bobbycar-graz/bobby-flasher/README.md

# bobby-flasher

### Screenshots
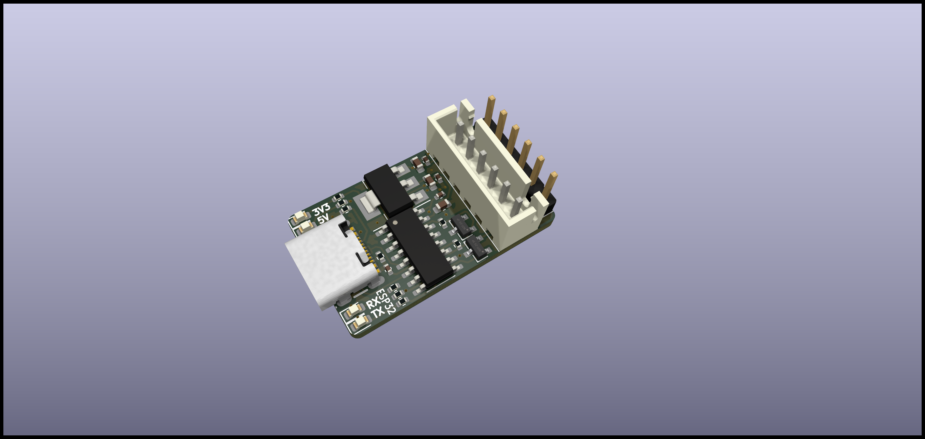
[picture p1: bobby-flasher.png]
Image of pcb
