bobbycar-graz/bobby-flasher/bobby-flasher.kicad_pcb

## KiCad design bobby-flasher.kicad_pcb (2026-01-31)

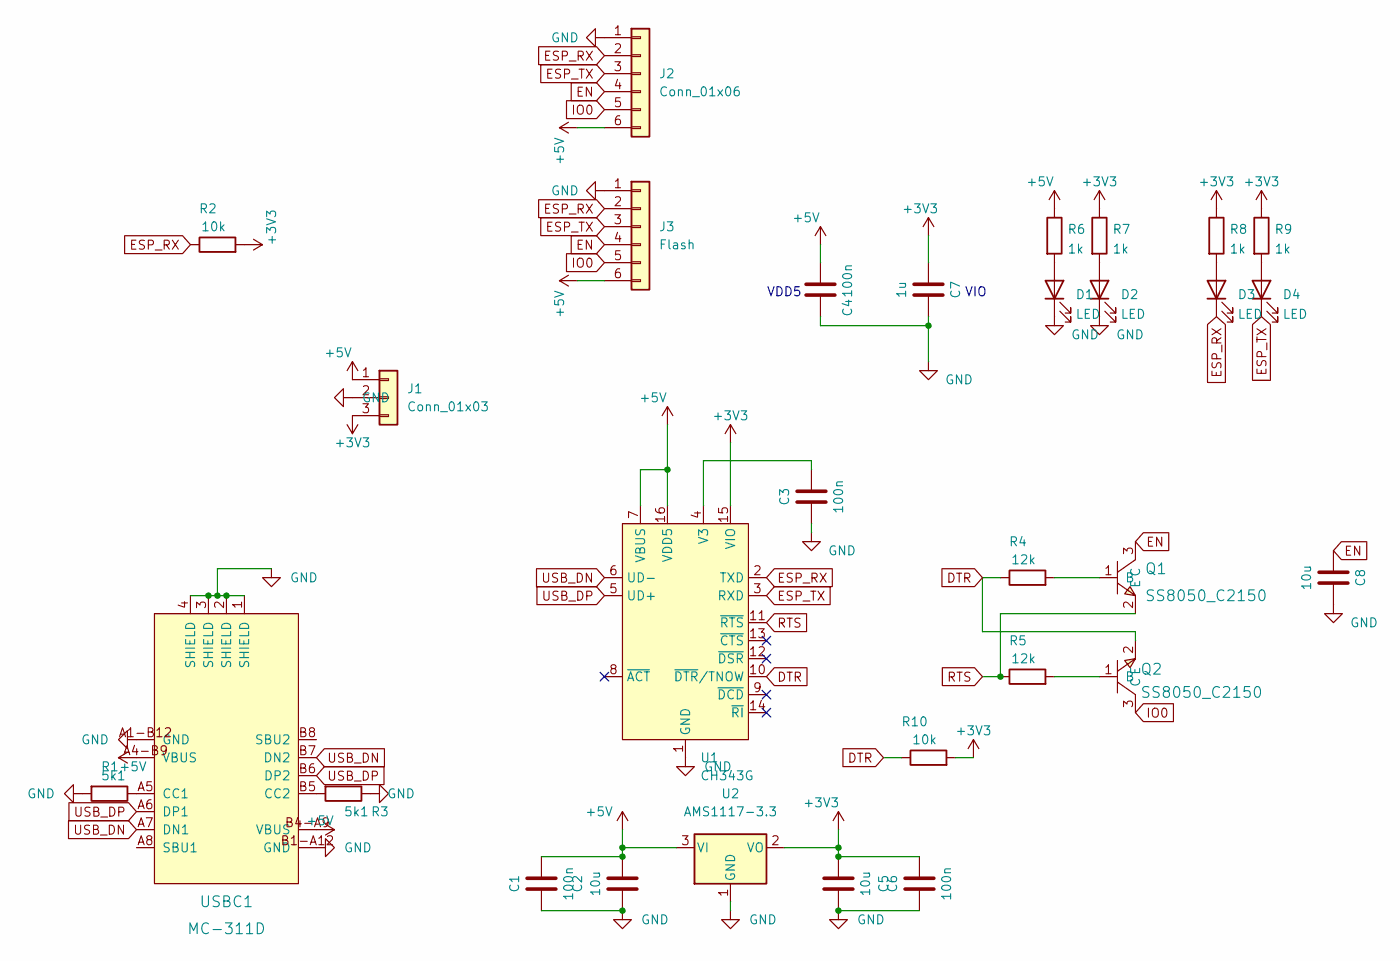
[picture p2: schematic bobby-flasher.kicad_sch]

Parts:
C1, C3, C4, C6: 100n; C_0402_1005Metric; LCSC Part # C1525
C2, C5, C8: 10u; C_0603_1608Metric; LCSC Part # C96446
C7: 1u; C_0603_1608Metric; LCSC Part # C15849
D1: LED; LED_0603_1608Metric; LCSC C2286
D2, D4: LED; LED_0603_1608Metric; LCSC C965807
D3: LED; LED_0603_1608Metric; LCSC C2290
J1: Conn_01x03; PinHeader_1x03_P2.54mm_Vertical
J2: Conn_01x06; PinHeader_1x06_P2.54mm_Vertical
J3: Flash; JST_XH_B6B-XH-A_1x06_P2.50mm_Vertical; LCSC C5663
Q1, Q2: SS8050_C2150; SOT-23; LCSC Part C2150
R1, R3: 5k1; R_0402_1005Metric; LCSC C25905
R2, R10: 10k; R_0402_1005Metric; LCSC C25744
R4, R5: 12k; R_0402_1005Metric; LCSC C25752
R6, R7, R8, R9: 1k; R_0402_1005Metric; LCSC C11702
U1: CH343G; SOIC-16_3.9x9.9mm_P1.27mm; LCSC C2844153
U2: AMS1117-3.3; SOT-223-3_TabPin2; LCSC C6186
USBC1: MC-311D; USB-C-SMD_MC-311D; LCSC Part C136423

Connections:
+3V3: C5.1, C6.2, C7.2, J1.3, R2.2, R7.1, R8.1, R9.1, R10.2, U1.15 (VIO), U2.2 (VO)
+5V: C1.2, C2.2, C4.2, J1.1, J2.6, J3.6, R6.1, U1.7 (VBUS), U1.16 (VDD5), U2.3 (VI), USBC1.A4-B9 (VBUS), USBC1.B4-A9 (VBUS)
DTR: Q2.2 (E), R4.1, R10.1, U1.10 (~DTR/TNOW)
EN: C8.2, J2.4, J3.4, Q1.3 (C)
ESP_RX: D3.1 (K), J2.2, J3.2, R2.1, U1.2 (TXD)
ESP_TX: D4.1 (K), J2.3, J3.3, U1.3 (RXD)
GND: C1.1, C2.1, C3.1, C4.1, C5.2, C6.1, C7.1, C8.1, D1.1 (K), D2.1 (K), J1.2, J2.1, J3.1, R1.2, R3.1, U1.1 (GND), U2.1 (GND), USBC1.1 (SHIELD), USBC1.2 (SHIELD), USBC1.3 (SHIELD), USBC1.4 (SHIELD), USBC1.A1-B12 (GND), USBC1.B1-A12 (GND)
IO0: J2.5, J3.5, Q2.3 (C)
unnamed: D1.2 (A), R6.2
unnamed: D2.2 (A), R7.2
unnamed: D3.2 (A), R8.2
unnamed: D4.2 (A), R9.2
unnamed: Q1.1 (B), R4.2
unnamed: Q2.1 (B), R5.2
unnamed: C3.2, U1.4 (V3)
unnamed: R1.1, USBC1.A5 (CC1)
unnamed: R3.2, USBC1.B5 (CC2)
RTS: Q1.2 (E), R5.1, U1.11 (~RTS)
USB_DN: U1.6 (UD-), USBC1.A7 (DN1), USBC1.B7 (DN2)
USB_DP: U1.5 (UD+), USBC1.A6 (DP1), USBC1.B6 (DP2)

Notes on the sheet:
VIO
VDD5

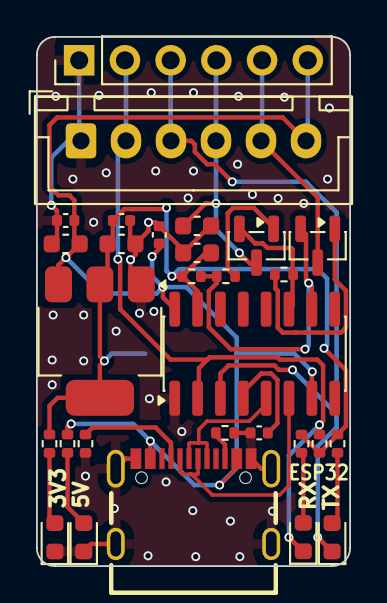
[picture p3: board bobby-flasher.kicad_pcb from above]

Board: 2 copper layers, 17.4 x 29.4 mm, 30 parts (1 on the bottom side), 20 nets.
