bobbycar-graz/bobby-flasher/(commit log)

2022-07-13 new layout, added leds
    [bobby-flasher.kicad_pcb, bobby-flasher.kicad_sch]
2022-07-13 Updated pcb
    [bobby-flasher.kicad_pcb]
2022-08-01 Updated files
    [bobby-flasher.kicad_pcb, bobby-flasher.kicad_sch]
2022-12-13 Added 10k pullup to DTR
    [bobby-flasher.kicad_pcb, bobby-flasher.kicad_sch]
2022-12-13 Updated schematic
    [bobby-flasher.kicad_sch]
2022-12-15 peters fixes, resistor on DTR missing
    [bobby-flasher-B_Cu.gbr, bobby-flasher-B_Mask.gbr, bobby-flasher-B_Paste.gbr, bobby-flasher-B_Silkscreen.gbr, bobby-flasher-CuBottom.gbr, bobby-flasher-CuTop.gbr, bobby-flasher-EdgeCuts.gbr, bobby-flasher-Edge_Cuts.gbr]
2024-12-11 fixed version
    [bobby-flasher-B_Cu.gbr, bobby-flasher-B_Mask.gbr, bobby-flasher-B_Paste.gbr, bobby-flasher-B_Silkscreen.gbr, bobby-flasher-CuBottom.gbr, bobby-flasher-CuTop.gbr, bobby-flasher-EdgeCuts.gbr, bobby-flasher-Edge_Cuts.gbr]
2026-01-31 Ordered at JLCPCB; remove unconnected resistor from schematic; mark NPTH holes of USB-C as NPTH; fix connection of transistor in PCB file; replace unavailable LEDs with alternatives
    [bobby-flasher-B_Cu.gbr, bobby-flasher-B_Mask.gbr, bobby-flasher-B_Paste.gbr, bobby-flasher-B_Silkscreen.gbr, bobby-flasher-CuBottom.gbr, bobby-flasher-CuTop.gbr, bobby-flasher-EdgeCuts.gbr, bobby-flasher-Edge_Cuts.gbr]
